HomoElectromagneticus/EHX_DMM_clocking/README.md

# EHX_DMM_clocking
This is a project to replace the original clock on an EHX Deluxe Memory man with something more capable.

The micro used is a PIC16F18326. It's NCO peripheral will be extremely useful for clock generation.

# License
CC BY-NC-SA https://creativecommons.org/licenses/by-nc-sa/4.0/
