HomoElectromagneticus/EHX_DMM_clocking/hw/ehx_dmm_clk.kicad_pcb

## KiCad design hw/ehx_dmm_clk.kicad_pcb (2020-09-07)

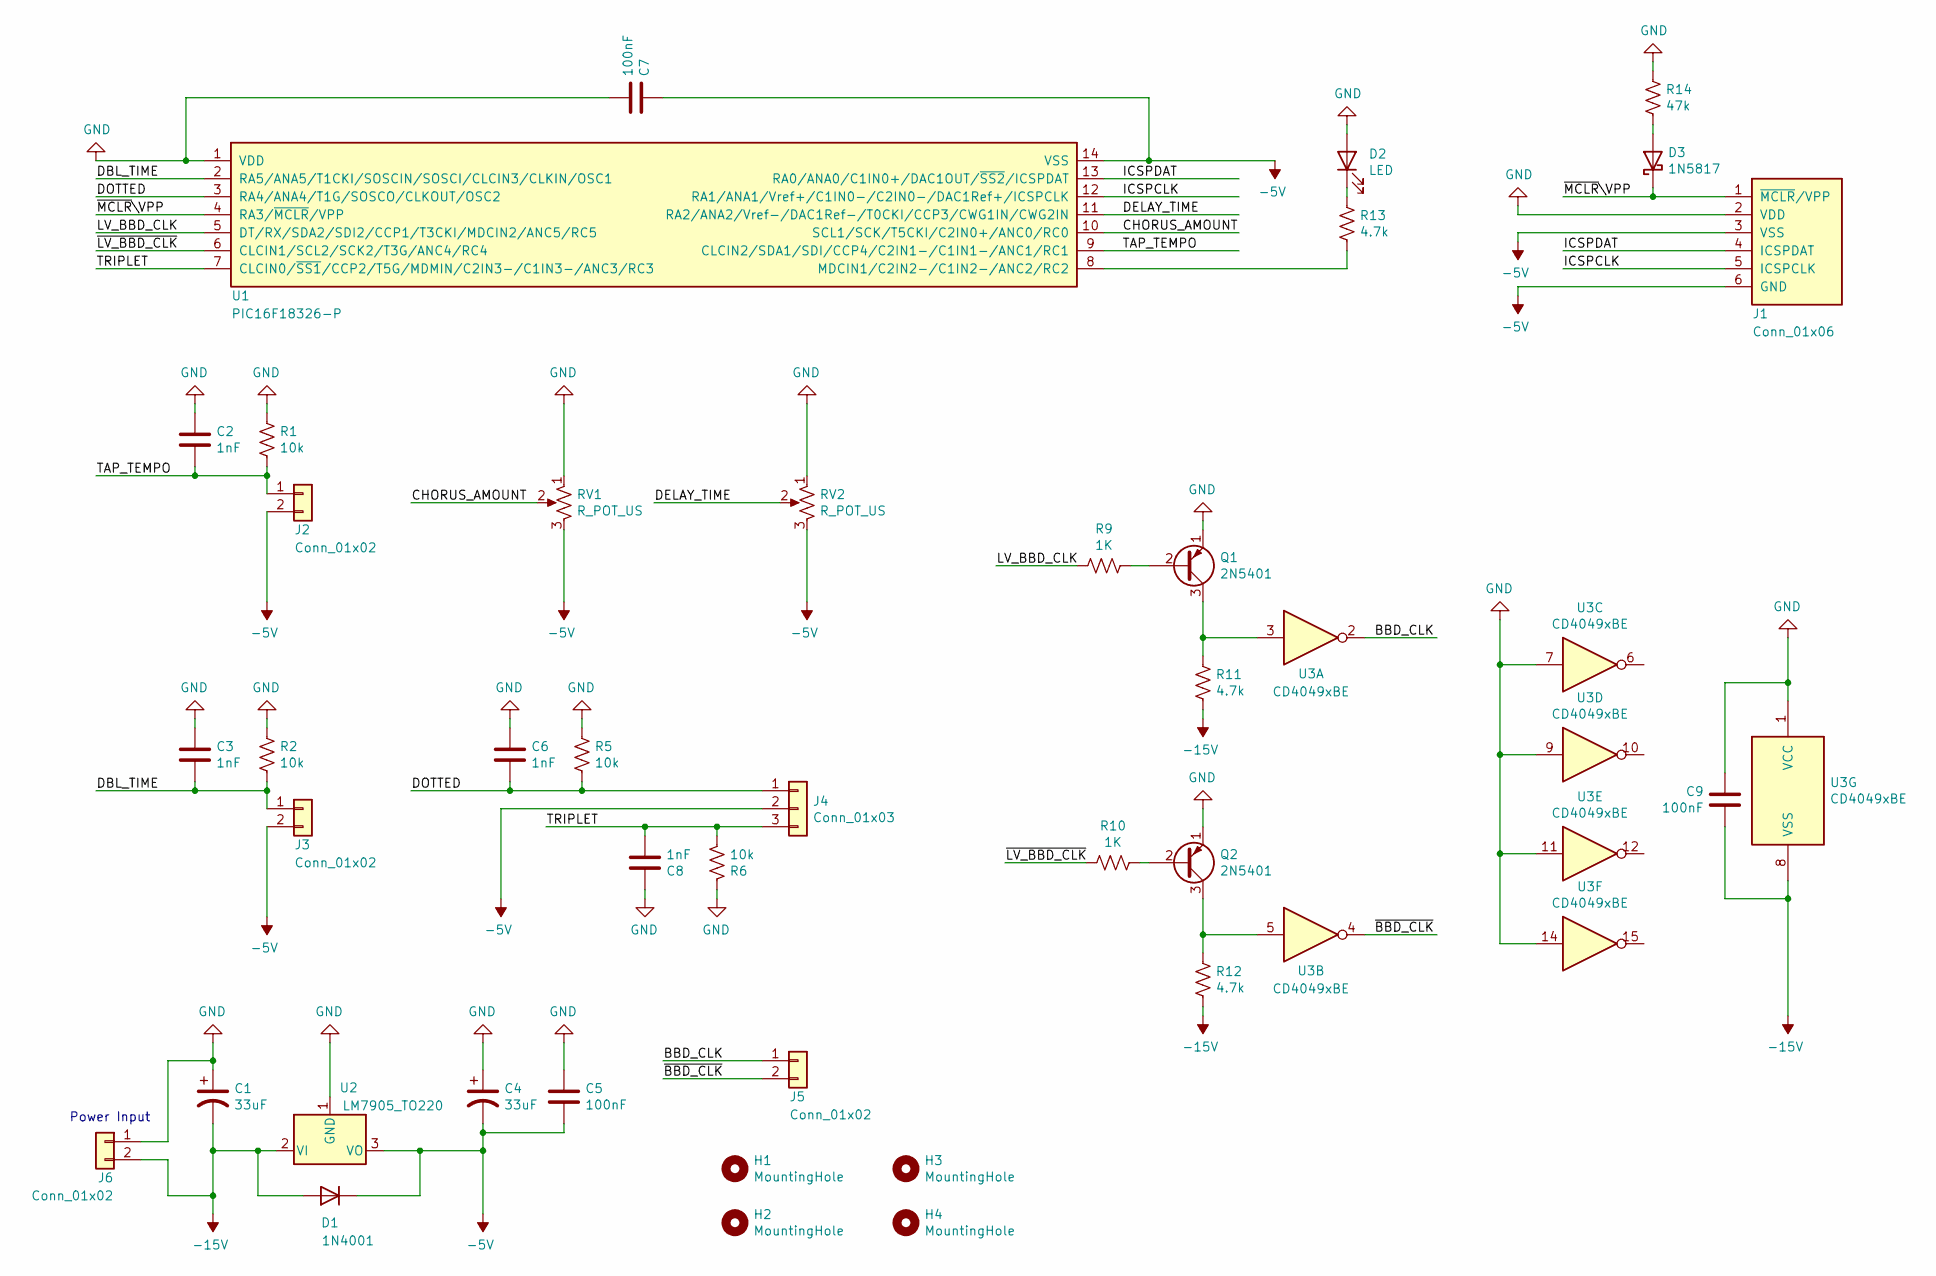
[picture p1: schematic ehx_dmm_clk.sch, EHX DMM Clock]

Parts:
C1, C4: 33uF; CP_Radial_D8.0mm_P2.50mm
C2, C3, C6, C8: 1nF; C_Rect_L7.0mm_W2.5mm_P5.00mm
C5, C7, C9: 100nF; C_Rect_L10.0mm_W3.0mm_P7.50mm_FKS3_FKP3
D1: 1N4001; D_DO-41_SOD81_P10.16mm_Horizontal
D2: LED; LED_D3.0mm
D3: 1N5817; D_DO-41_SOD81_P10.16mm_Horizontal
H1, H2, H3, H4: MountingHole; MountingHole_3mm
J1: Conn_01x06; PinHeader_1x06_P2.54mm_Vertical
J2, J3, J5, J6: Conn_01x02; PinHeader_1x02_P2.54mm_Vertical
J4: Conn_01x03; PinHeader_1x03_P2.54mm_Vertical
Q1, Q2: 2N5401; TO-92_HandSolder
R1, R2, R5, R6: 10k; R_Axial_DIN0207_L6.3mm_D2.5mm_P2.54mm_Vertical
R9, R10: 1K; R_Axial_DIN0207_L6.3mm_D2.5mm_P2.54mm_Vertical
R11, R12, R13: 4.7k; R_Axial_DIN0207_L6.3mm_D2.5mm_P2.54mm_Vertical
R14: 47k; R_Axial_DIN0207_L6.3mm_D2.5mm_P2.54mm_Vertical
RV1, RV2: R_POT_US; PinHeader_1x03_P2.54mm_Vertical
U1: PIC16F18326-P; DIP-14_W7.62mm_LongPads
U2: LM7905_TO220; TO-220-3_Vertical
U3: CD4049xBE; DIP-16_W7.62mm_LongPads

Connections:
-5V: C4.2, C5.2, C7.1, D1.1 (K), J1.3 (VSS), J1.6 (GND), J2.2, J3.2, J4.2, RV1.3, RV2.3, U1.14 (VSS), U2.3 (VO)
-15V: C1.2, C9.2, D1.2 (A), J6.2, R11.2, R12.2, U2.2 (VI), U3.8 (VSS)
/BBD_CLK: J5.1, U3.2
/CHORUS_AMOUNT: RV1.2, U1.10 (SCL1/SCK/T5CKI/C2IN0+/ANC0/RC0)
/DBL_TIME: C3.2, J3.1, R2.2, U1.2 (RA5/ANA5/T1CKI/SOSCIN/SOSCI/CLCIN3/CLKI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)
/DELAY_TIME: RV2.2, U1.11 (RA2/ANA2/Vref-/DAC1Ref-/T0CKI/CCP3/CWG1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)
/DOTTED: C6.2, J4.1, R5.2, U1.3 (RA4/ANA4/T1G/SOSCO/CLKOUT/OSC2)
/ICSPCLK: J1.5 (ICSPCLK), U1.12 (RA1/ANA1/Vref+/C1IN0-/C2IN0-/DAC1Ref+/I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)
/ICSPDAT: J1.4 (ICSPDAT), U1.13 (RA0/ANA0/C1IN0+/DAC1OUT/~SS2~/ICSPDAT)
/LV_BBD_CLK: R9.2, U1.5 (DT/RX/SDA2/SDI2/CCP1/T3CKI/MDCIN2/ANC5/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)
/TAP_TEMPO: C2.2, J2.1, R1.2, U1.9 (CLCIN2/SDA1/SDI/CCP4/C2IN1-/C1IN1-/ANC1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)
/TRIPLET: C8.2, J4.3, R6.2, U1.7 (CLCIN0/~SS1~/CCP2/T5G/MDMIN/C2IN3-/C1IN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)
/~BBD_CLK: J5.2, U3.4
/~LV_BBD_CLK: R10.2, U1.6 (CLCIN1/SCL2/SCK2/T3G/ANC4/RC4)
/~MCLR~\VPP: D3.1 (K), J1.1 (~MCLR~/VPP), U1.4 (RA3/~MCLR~/VPP)
GND: C1.1, C2.1, C3.1, C4.1, C5.1, C6.1, C7.2, C8.1, C9.1, D2.2 (A), J1.2 (VDD), J6.1, Q1.1 (E), Q2.1 (E), R1.1, R2.1, R5.1, R6.1, R14.1, RV1.1, RV2.1, U1.1 (VDD), U2.1 (GND), U3.1 (VCC), U3.7, U3.9, U3.11, U3.14
unnamed: D2.1 (K), R13.1
unnamed: D3.2 (A), R14.2
unnamed: Q1.2 (B), R9.1
unnamed: Q1.3 (C), R11.1, U3.3
unnamed: Q2.2 (B), R10.1
unnamed: Q2.3 (C), R12.1, U3.5
unnamed: R13.2, U1.8 (MDCIN1/C2IN2-/C1IN2-/ANC2/RC2)

Notes on the sheet:
Power Input

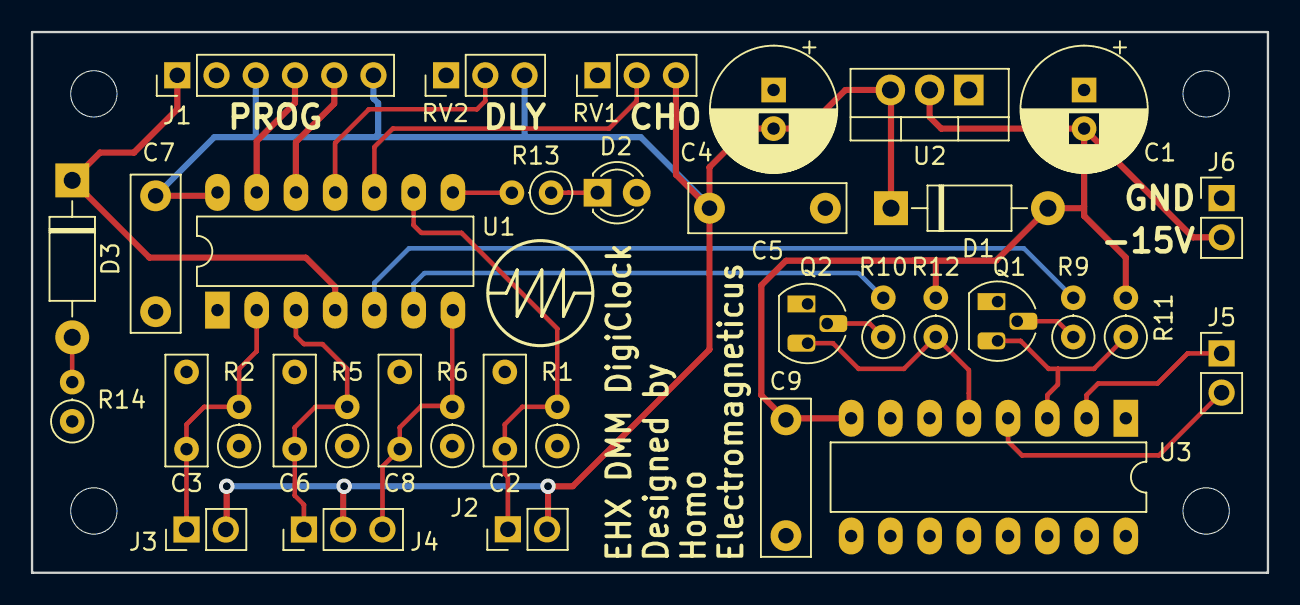
[picture p2: board ehx_dmm_clk.kicad_pcb from above]

Board: 2 copper layers, 80.0 x 35.0 mm, 39 parts (0 on the bottom side), 23 nets.
