HomoElectromagneticus/EHX_DMM_clocking/(commit log)

2020-07-10 Switched the project over to the PIC16F18326 since that part has an NCO
2020-07-12 ADC, NCO, and CWG are all working
2020-07-12 Added some calculations about the BBD clocks and delay time
    [clock_calculations.ods]
2020-07-12 Added a variable to store the tap tempo button state. Also tweaked the timer2 interrupt freq so that the potentiometer is scanned 10x a second instead of 7x.
2020-07-12 Added a button debounce routing using Timer4. I have the debounced button signal driving an LED right now for debugging purposes.
2020-07-12 fixed a comment about the ADC convertion time
    [main.c]
2020-07-13 Button debouncing works. Tap tempo needs a lot of work still, but periodic button pushing does change the output clock frequency...
2020-07-18 Made a lot of changes to how I was looking at the clock calculations.
    [clock_calculations.ods]
2020-07-18 Significantly optimized the tap tempo --> output clock rate calculation. Added a way to switch from tap tempo mode to 'delay time controlled by the knob' mode.
2020-07-18 Added another sheet to the clock calculations document
    [clock_calculations.ods]
2020-07-18 Slowed down the ADC converstion rate to get more accurate readings. The system has the time to allot for this.
2020-07-18 Added a sheet to help scale the ADC readings of knob position into NCO increment values for the output clock
    [clock_calculations.ods]
2020-07-18 Scaled the ADC readings into the 'stock range' of the DMM
2020-08-02 Initial refactor complete. Code ready for a chorus LFO
    [clock_calculations.ods]
2020-08-02 Setup ADC channel switching so that the chorus amount knob can be read in addition to the delay time knob
2020-08-02 Updated the clock calculations file to support the new way the code works for the delay knob.
    [clock_calculations.ods]
2020-08-03 Made quite a few changes to get the chorus LFO working right. Had the bring the NCO source clock frequency down by half, but this gives the program more resolution anyway. The chorus function works, 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
    [clock_calculations.ods]
2020-08-24 Updated gitignore to accomodate kicad files
2020-08-24 Initial commit of the electrical design. So far, it's just a schematic.
    [ehx_dmm_clk.kicad_pcb, ehx_dmm_clk.sch]
2020-08-24 Did a bit of reorganization for just the project documentation
    [clock_calculations.ods]
2020-08-24 Schematic annotated
    [ehx_dmm_clk.sch]
2020-08-24 Footprint assignment complete
    [ehx_dmm_clk.sch]
2020-08-24 Added connections for power input and clock output
    [ehx_dmm_clk.sch]
2020-08-24 Initial commit of the PCB
    [ehx_dmm_clk.kicad_pcb]
2020-08-24 Removed some unnecessary resistors
    [ehx_dmm_clk.sch]
2020-08-24 Initial work on the PCBA layout
    [ehx_dmm_clk.kicad_pcb]
2020-08-25 Initial PCB floorplanning complete
    [ehx_dmm_clk.kicad_pcb]
2020-08-25 Added some mounting holes
    [ehx_dmm_clk.kicad_pcb, ehx_dmm_clk.sch]
2020-09-07 Huge commit. Major changes to board size, layout, footprints, etc. All to get the design to fit into the enclosure
    [ehx_dmm_clk.kicad_pcb, ehx_dmm_clk.sch]
