HomoElectromagneticus/EHX_DMM_clocking/(notices)

Notices in the files:
hw/ehx_dmm_clk.kicad_pcb:
CC BY-NC-SA 4.0
